sahelalsharu/space-modulated-acoustic-communication/pcb/pcb_schematic.pdf

Transmitter Tx1 | Receiver Rx1

## Transmitter Tx3

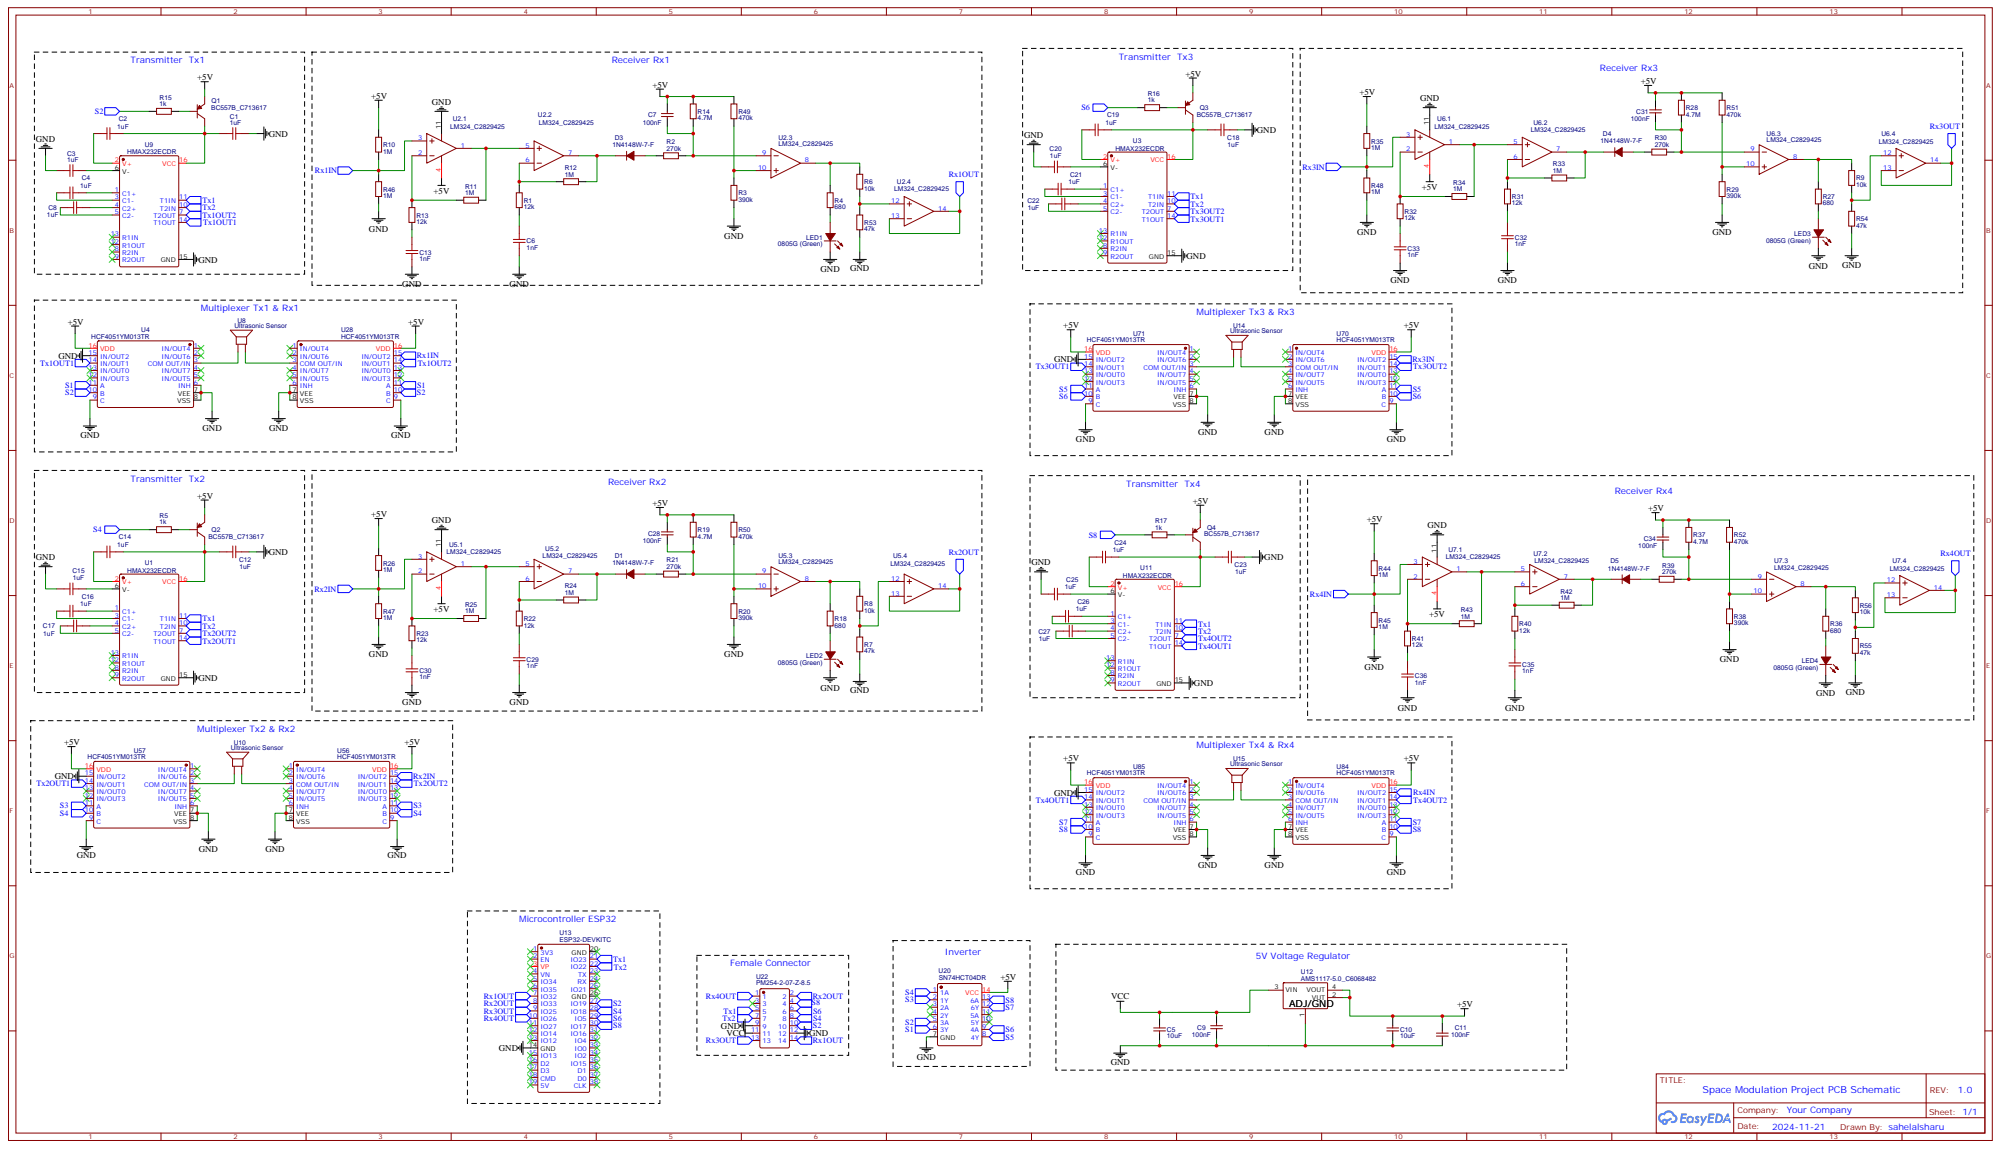
[picture p16: page 1]

HCF4051YM013TR
11 IN/OUT3 12 IN/OUT0 13 IN/OUT1 14 IN/OUT2 15 VDD 16
