sahelalsharu/space-modulated-acoustic-communication/pcb/pcb_layout.pdf

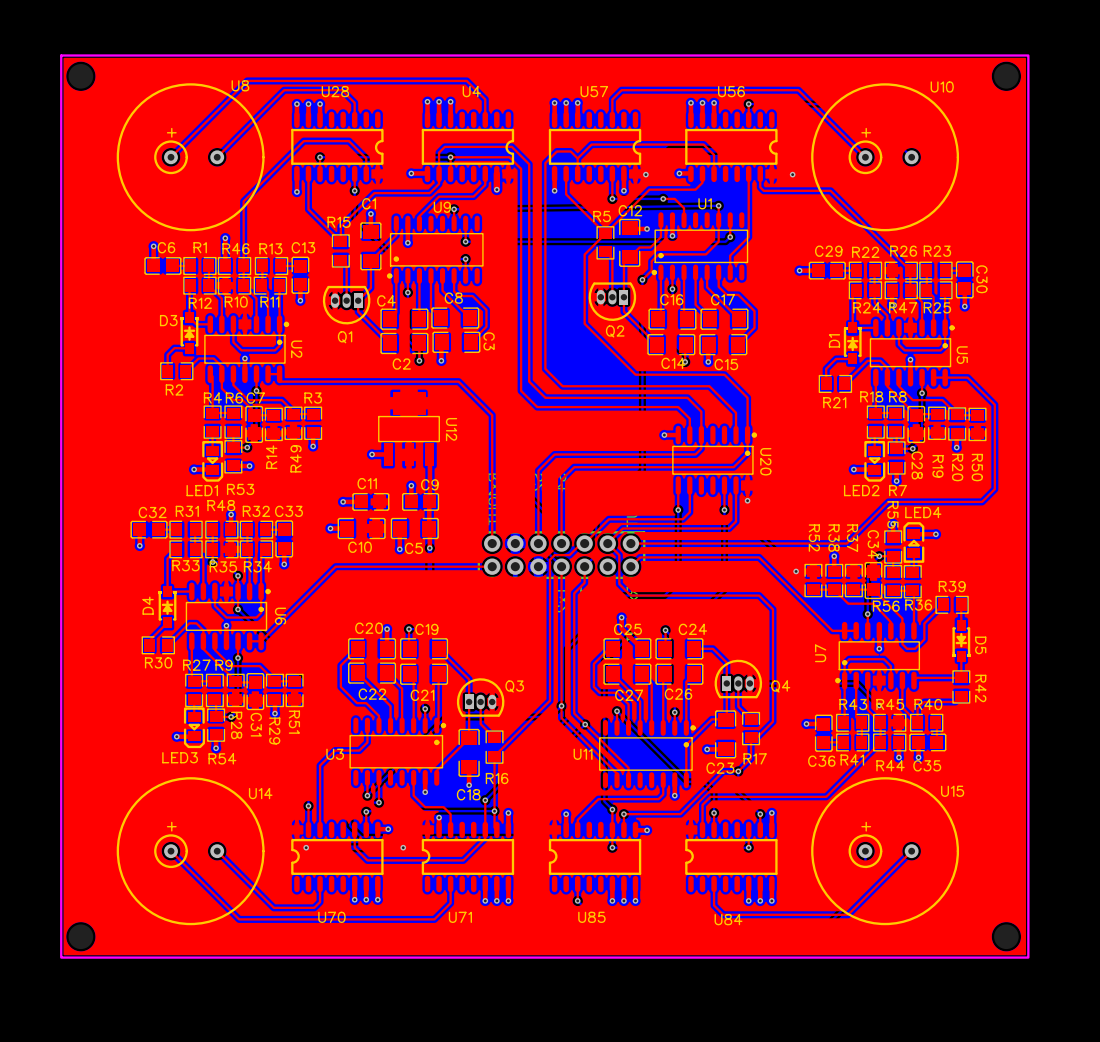
[picture p17: page 1]
