sahelalsharu/space-modulated-acoustic-communication/(list of files, drawings)

Other design files:
pcb/pcb_layout.json
pcb/pcb_schematic.json
